memphis242/can_node_board/hardware/test_circuits/can_test/can_test_breadboard_setup.jpg

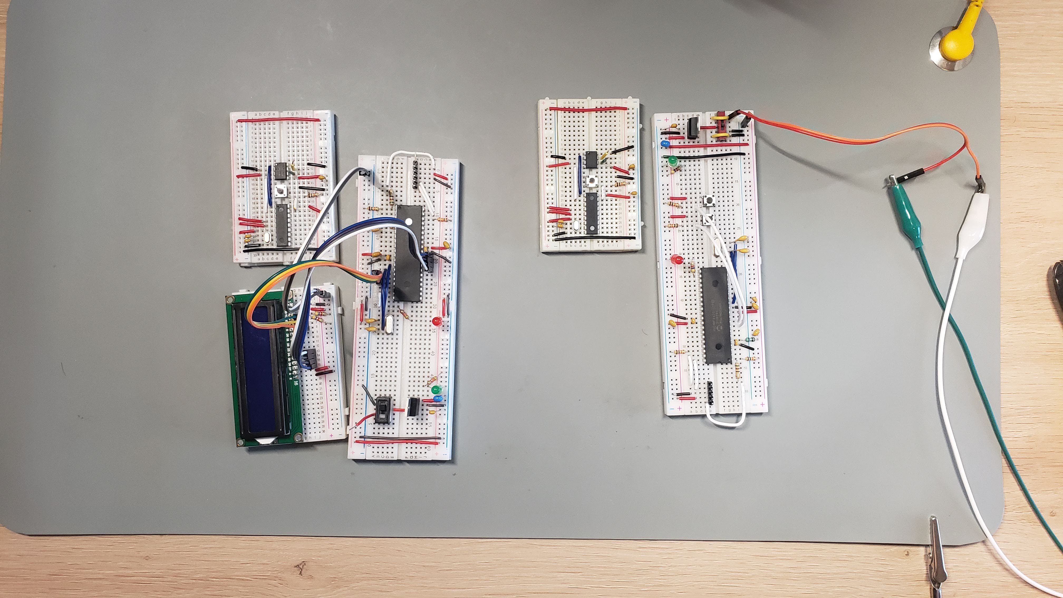
hardware/test_circuits/can_test/can_test_breadboard_setup.jpg
