memphis242/can_node_board/hardware/test_circuits/pic18f4620_can_test_sch.pdf

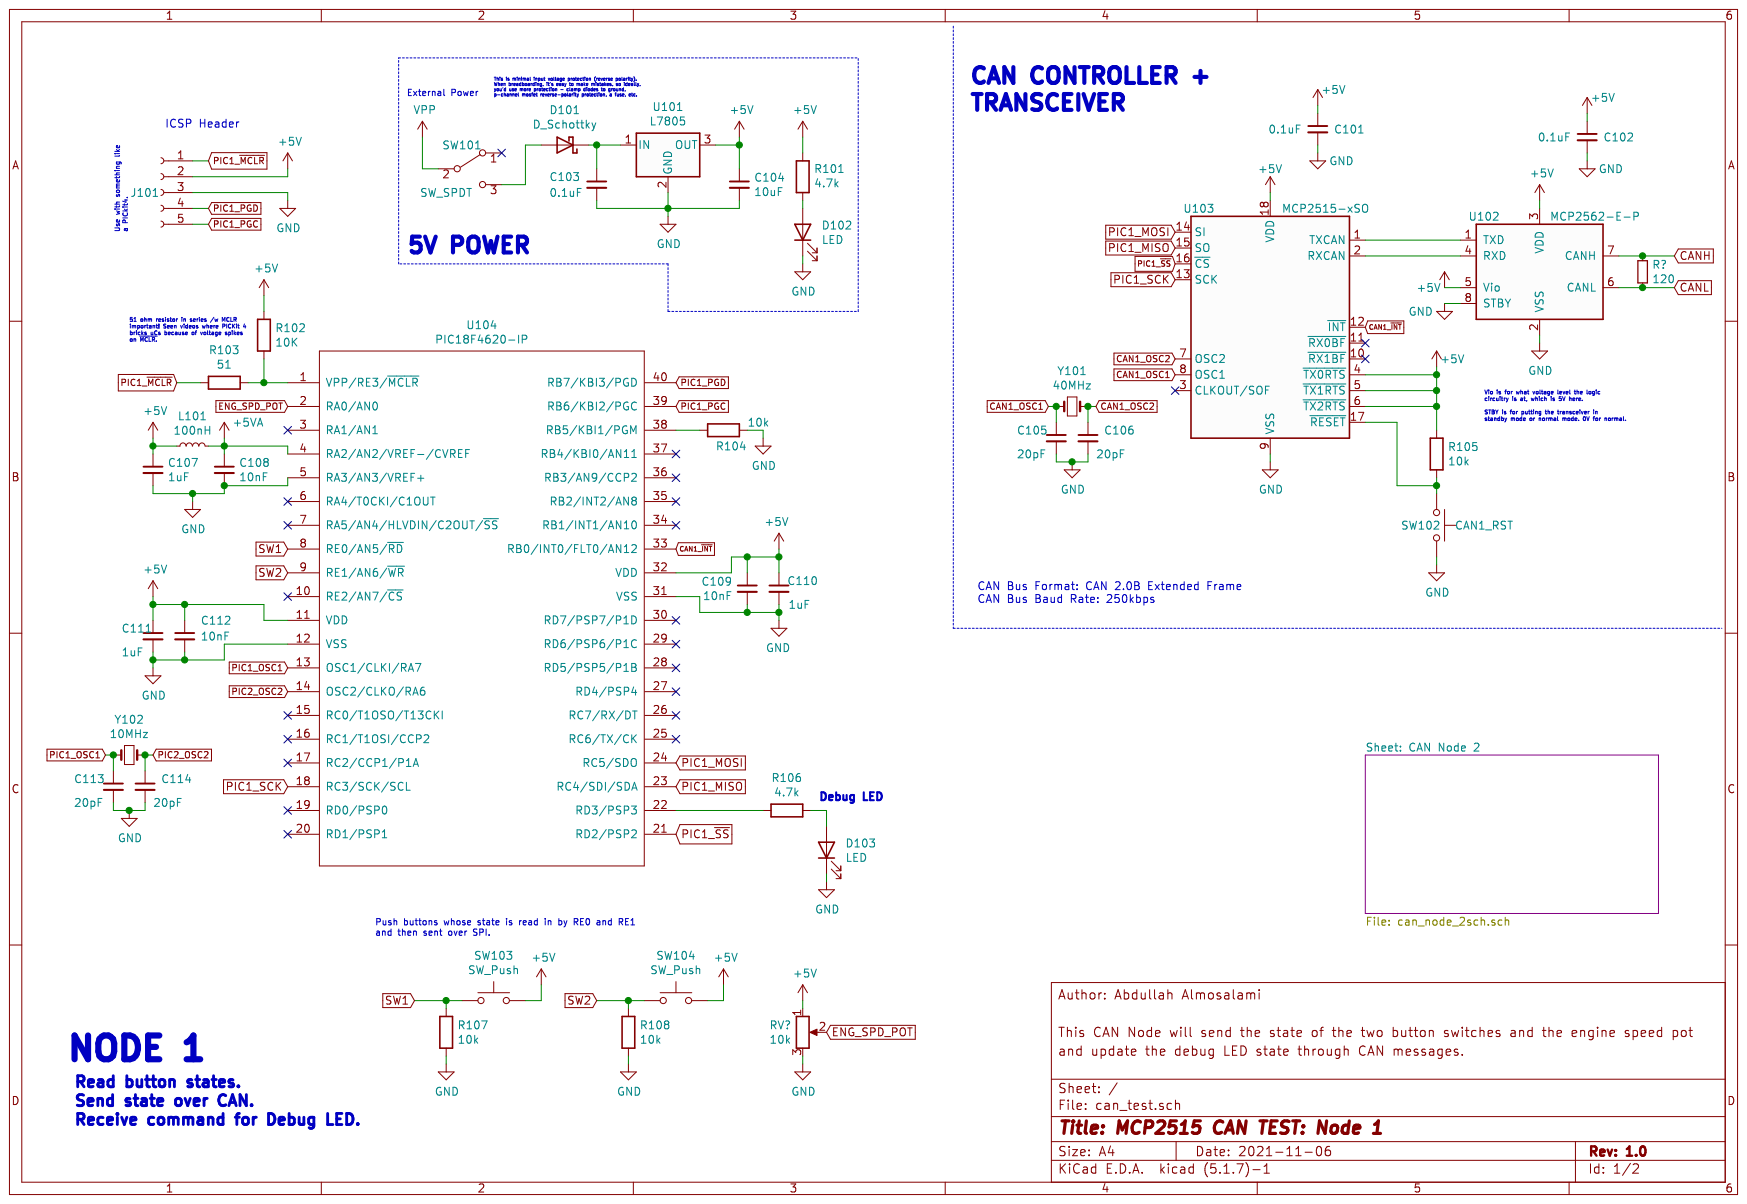
[picture p2: page 1]

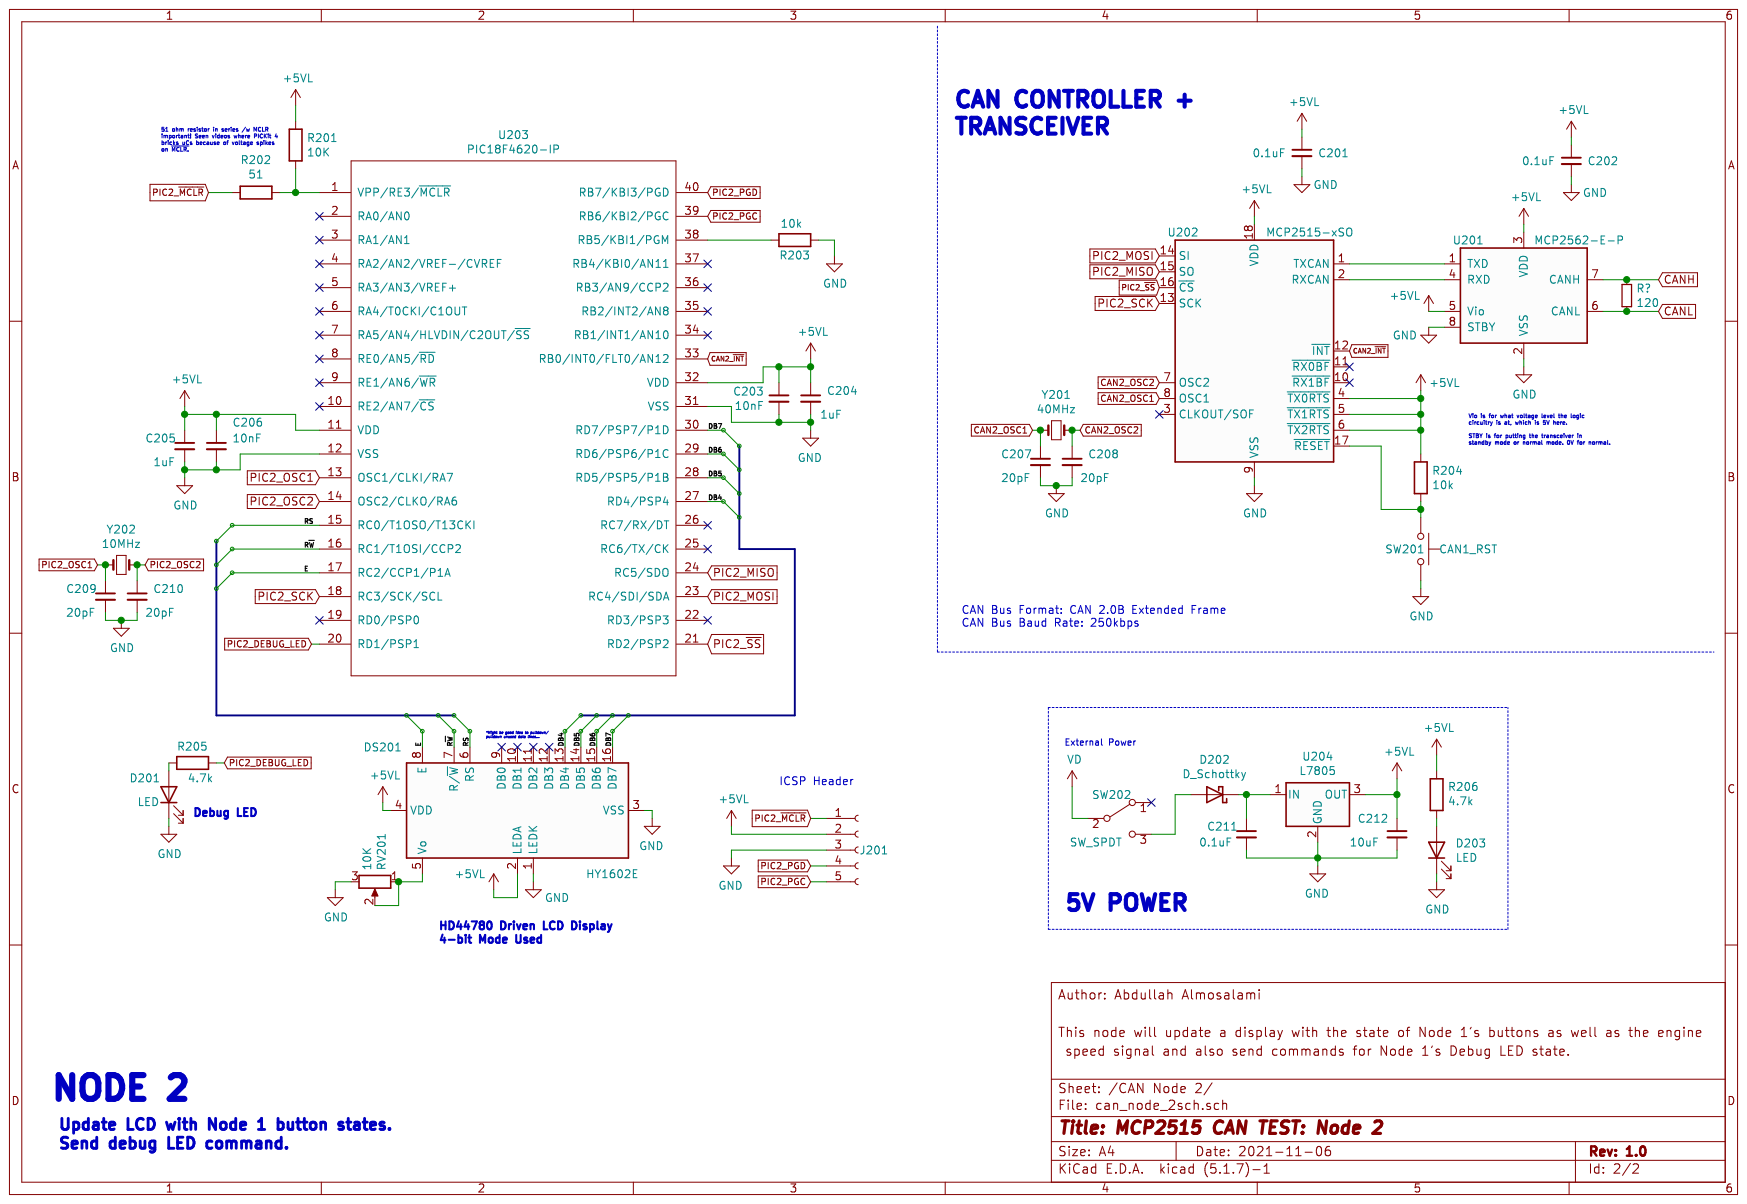
[picture p3: page 2]
