memphis242/can_node_board/hardware/test_circuits/pic18f4620_spi_test_sch.pdf

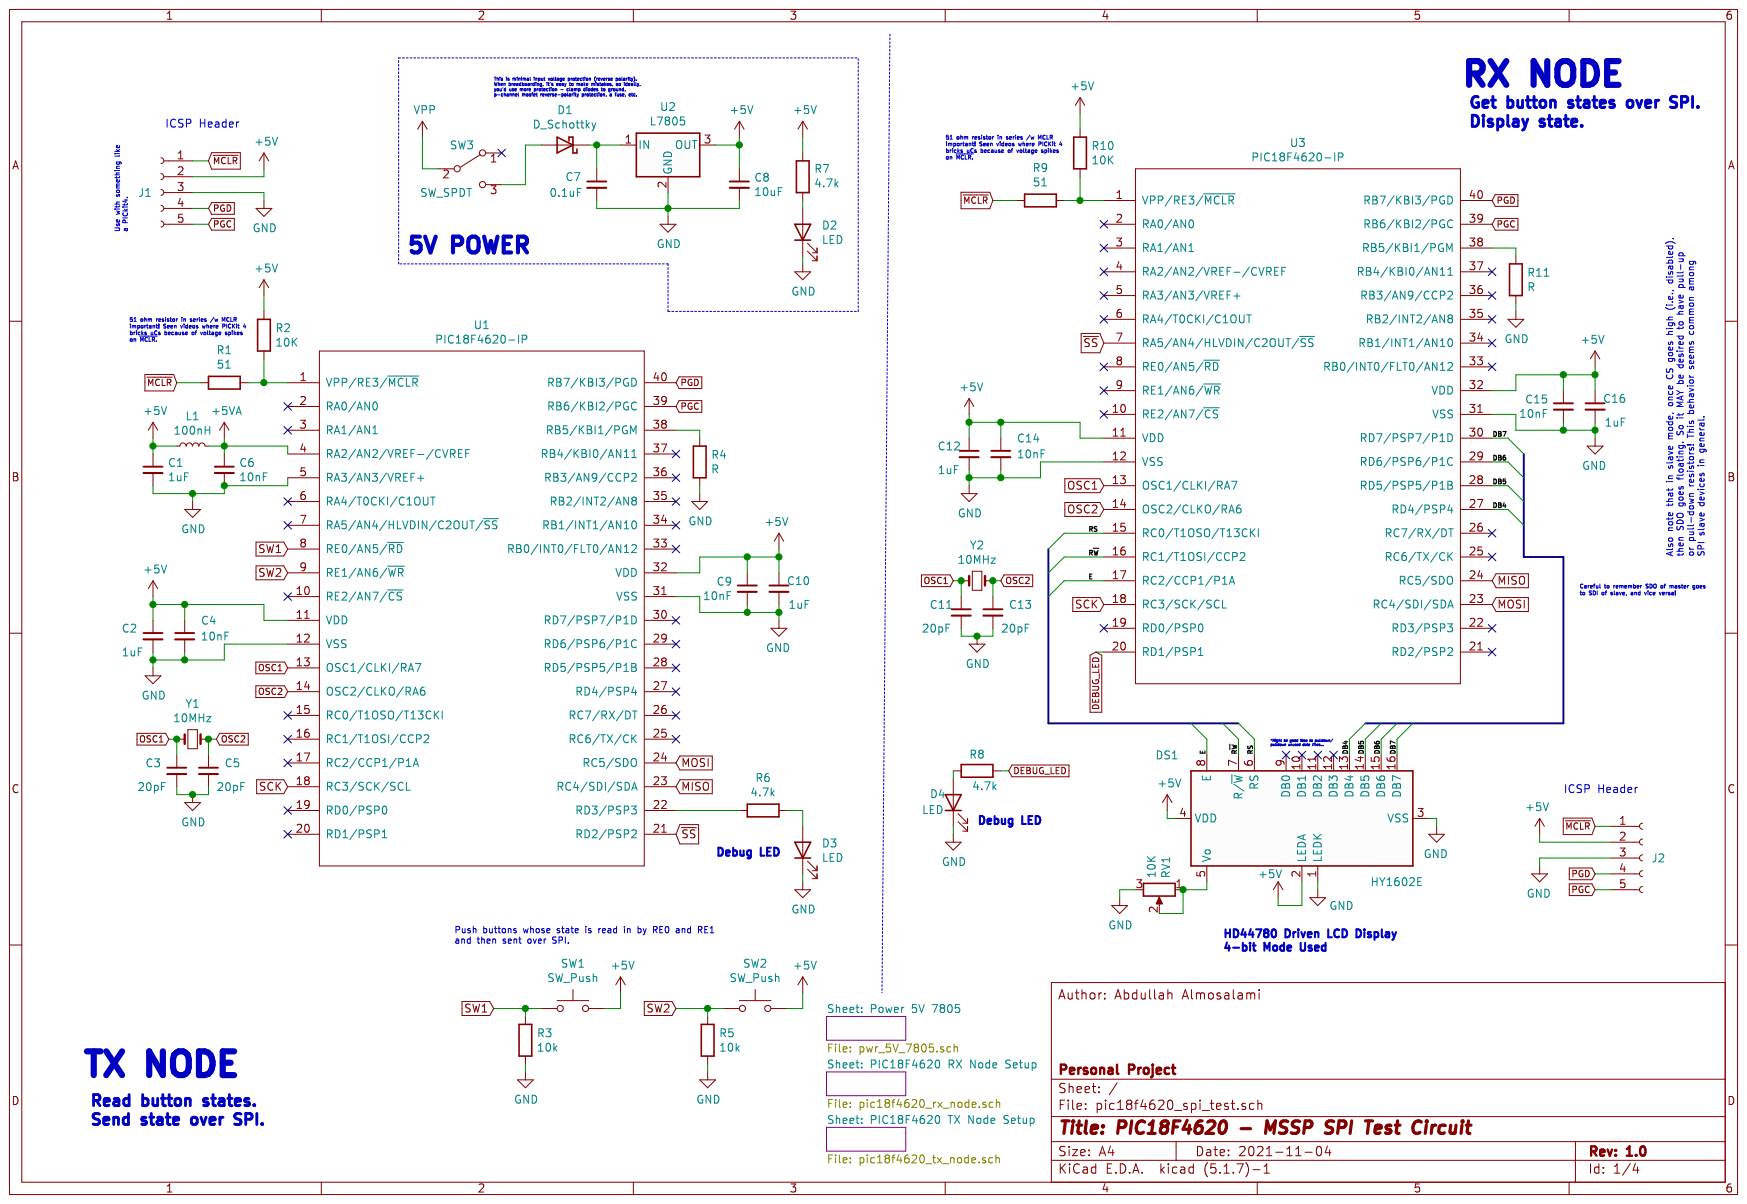
[picture p4: page 1]

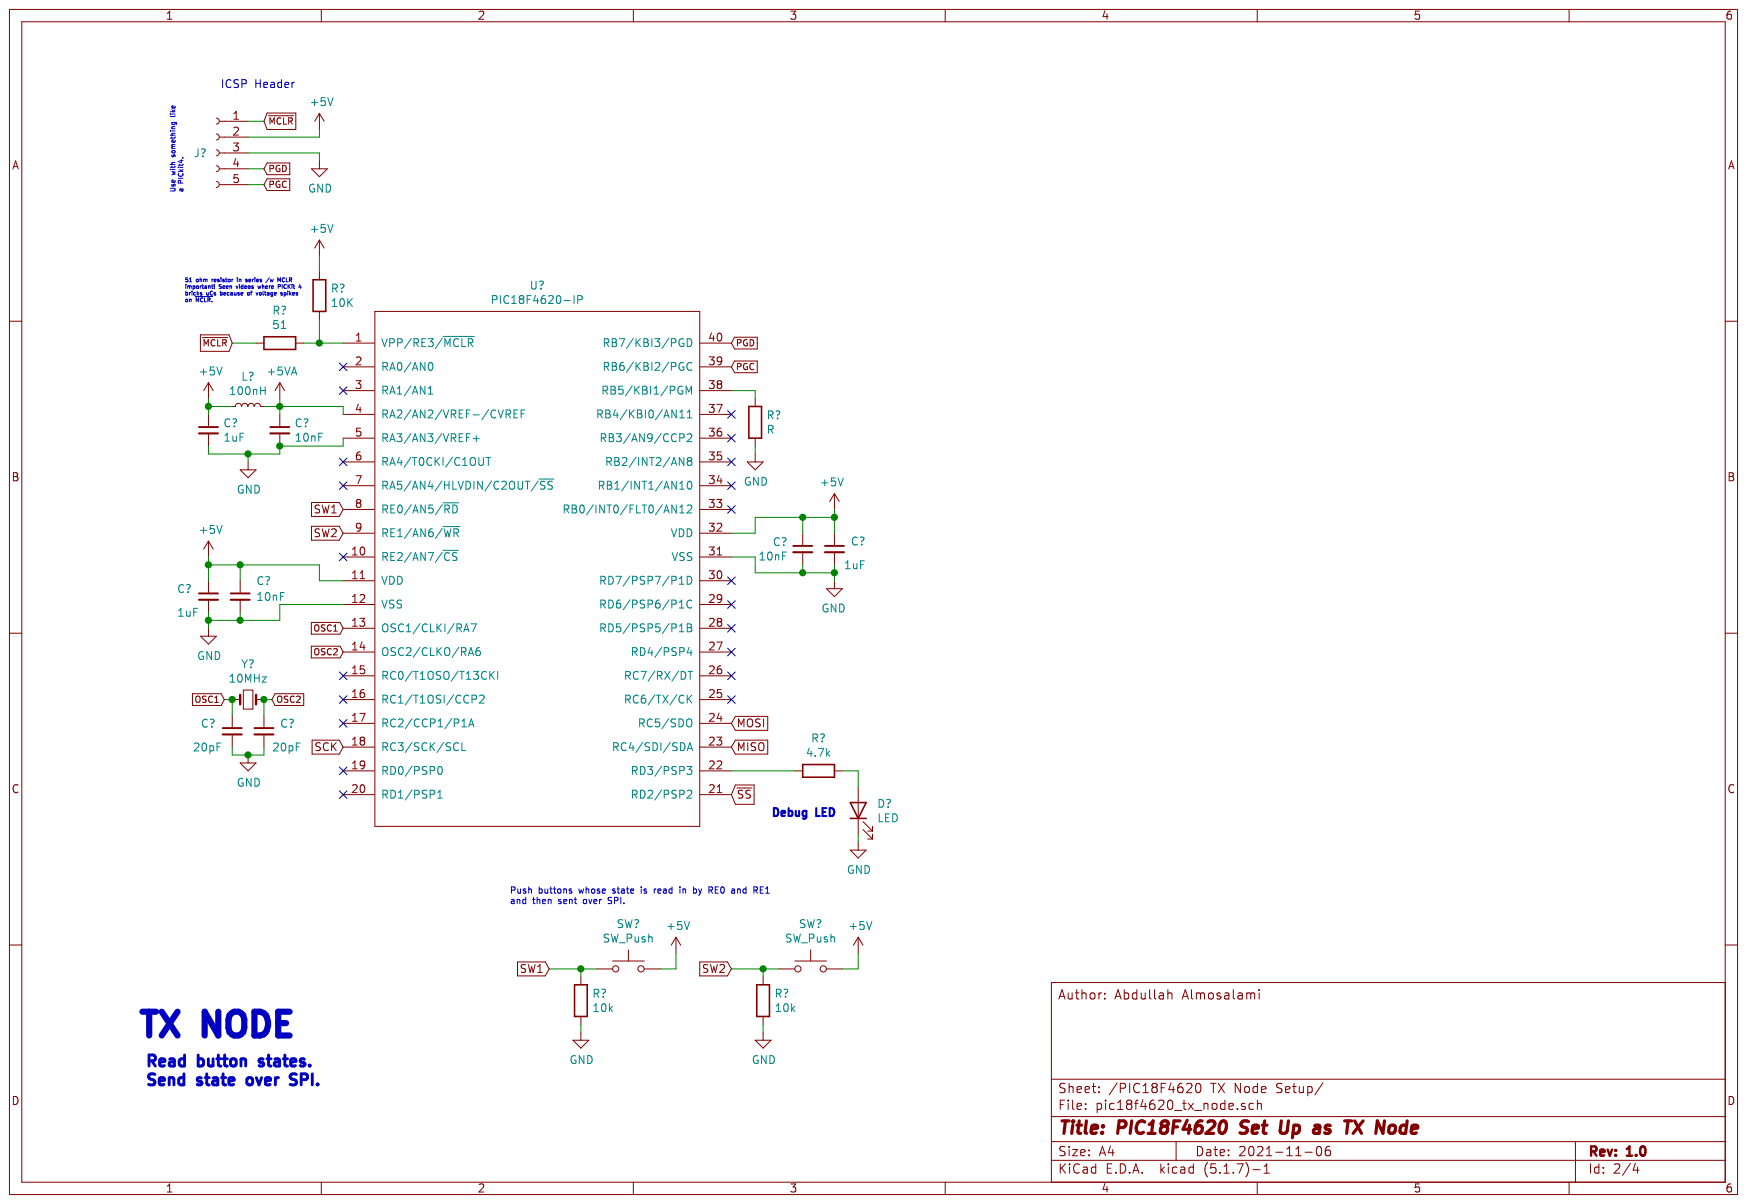
[picture p5: page 2]

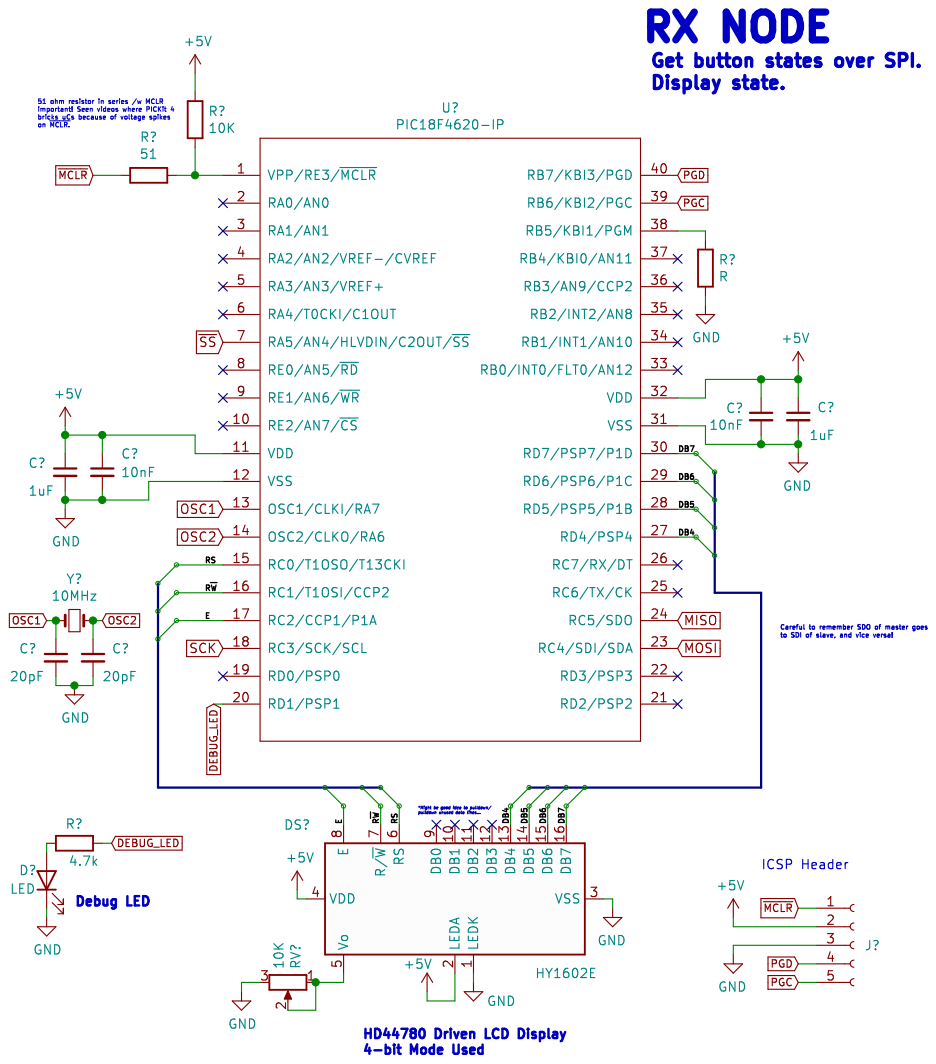
[picture p6: page 3]

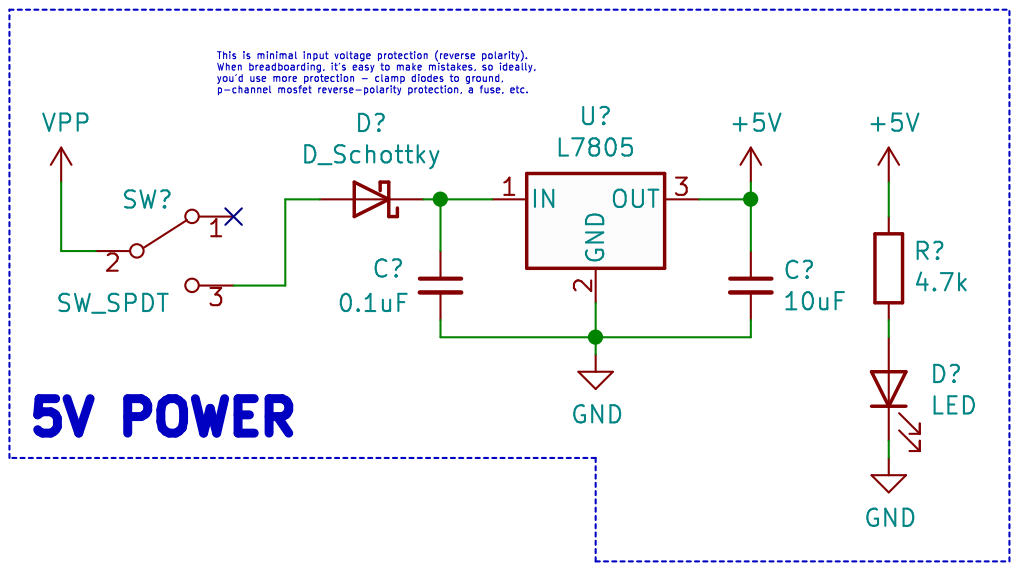
[picture p7: page 4]
