memphis242/can_node_board/can_node_board_SW.X/src/timer.c

/*
 * File:   timer.c
 * Author: Abdullah Almosalami
 *
 * Created on October 28, 2021, 10:12 PM
 */


#include <xc.h>
#include "timer.h"
#include "ccp.h"


// Global or static variables relevant to the timer modules


// Functions

// Timer1

/* Function: Timer1_Init_Default
 * ---------------------------------
 * Initialize Timer1 in the default manner, which for this project will be for
 * T1CON to be configured for 16-bit R/W, prescaler of 8, tmr1 osc off,
 * internal clock, tmr1 off
 * 
 * Parameters: none
 * 
 * Returns: none
 */
void Timer1_Init_Default(void){
    TMR1_DEFAULT;
    TMR1_PRESCAL_8;
//    TMR1_ENABLE_INTERRUPT;
//    ENABLE_PERIPHERAL_INTERRUPTS;
}

void Timer3_Init_Default(void) {
    TMR3_DEFAULT;
    TMR3_PRESCALE_8;
//    TMR3_ENABLE_INTERRUPT;
//    ENABLE_PERIPHERAL_INTERRUPTS;
}

/* Function: Timer1_Enable
 * ---------------------------------
 * Turns Timer1 on.
 * 
 * Parameters: none
 * 
 * Returns: none
 */
void Timer1_Enable(void){
    TMR1_ON;
}

/* Function: Timer1_Disable
 * ---------------------------------
 * Turns Timer1 off.
 * 
 * Parameters: none
 * 
 * Returns: none
 */
void Timer1_Disable(void){
    TMR1_OFF;
}

/* Function: Timer3_Enable
 * ---------------------------------
 * Turns Timer3 on.
 * 
 * Parameters: none
 * 
 * Returns: none
 */
void Timer3_Enable(void){
    TMR3_ON;
}

/* Function: Timer3_Disable
 * ---------------------------------
 * Turns Timer3 off.
 * 
 * Parameters: none
 * 
 * Returns: none
 */
void Timer3_Disable(void){
    TMR3_OFF;
}


//    // Timer1 Overflow Interrupt
//    if(TMR1_IF && TMR1_ENABLE_BIT) {
//        
//        spi_ready_to_tx = 0x01;
//        
//        TMR1_CLEAR_IF;
//    }
