memphis242/can_node_board/(commit log)

2021-11-03 Wrote up SPI test TX node code. Need to still do RX node.
2021-11-03 Wrote up SPI test code now for both TX and RX Test nodes! Now to try it out...
2021-11-04 Fixed up test code along with peripheral code for TX node. SPI, Timer, and CCP all work great! I also fixed some of the LCD code for the RX node. Next up, hopefully making the RX node work and then w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
    [ccp.c, ccp.h, lcd_driver.c, lcd_driver.h, main.c, mssp_spi_driver.c, timer.c, timer.h]
2021-11-04 Ok, I think I'm happy with most of the test results. The acknowledge behavior is still not working as I believe it should but hopefully this isn't too important for this project. I also moved the tes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
    [main.c, spi_test.c]
2021-11-04 Added hardware folder to hold schematic and pcb files.
    [can_node_board_hw.kicad_pcb, can_node_board_hw.sch, can_node_board_pwr.sch, can_node_board_user_interface.sch, can_test.kicad_pcb, can_test.sch, j1939_test.kicad_pcb, j1939_test.sch]
2021-11-05 Completed the schematic for the PIC18F4620 SPI Test. I will note that the KiCAD DRC on the schematic still gives --Pin connected to other pins, but not driven by any pin-- warnings, and I have not be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
    [can_node_board_pwr.sch]
2021-11-05 Added a pdf export of my pic18f4620 spi test schematic.
2021-11-06 Added more documentation. Also fixed up some of the SPI and LCD code.
    [ccp.c, ccp.h, lcd_driver.c, lcd_driver.h, mssp_spi_driver.c, spi_test.c, spi_test.h, timer.c]
2021-11-06 Finished CAN Node 1 schematic page.
    [can_node_2sch.sch]
2021-11-06 Finished CAN Test schematic now. Also added schematics for the individual elements used so that it would make it easier to reuse for later schematics!
    [can_test.sch, pic18f4620_rx_node.sch, pic18f4620_spi_test.sch, pic18f4620_tx_node.sch, pwr_5V_7805.sch]
2021-11-07 Fixed up issues I had with ccp and timer that I didn't realize I had! :-|
    [ccp.c, ccp.h, mcp2515.c, mcp2515.h, spi_test.c, timer.c, timer.h]
2021-11-09 Completed draft the mcp2515.h and did minor edits to schematics.
    [pic18f4620_spi_test.sch]
2021-11-11 Fixed up some of the peripheral drivers.
    [ccp.c, ccp.h, lcd_driver.c, lcd_driver.h, mcp2515.h, timer.c, timer.h]
2021-11-11 Added a little to mcp2515.c and realized I would like to add file for external interrupts. So added external_interrupts.c and .h.
2021-11-12 Completed this first version of the external interrupt files.
2021-11-12 Added a little more to the mcp2515.c file and edited other files as I notice things like the spi files...
2021-11-15 Realized I probably want to actually use the ~INT pin on the MCP2515 for recognizing when a transmission has successfull occured... And if I'm using that, might as well also use it for RX interrupts 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
    [can_node_2sch.sch, can_test.sch]
2021-11-15 Complete the can_send routine --> will need to set up ISR as well still! Will include this as a comment at the end of the mcp2515.c file.
    [can_node_2sch.sch, can_test.sch]
2021-11-15 Ok. I think I've completed the draft MCP2515 driver files. Woo! That took a HOT SEC. Although I'm sure I'll find lots of bugs once I begin testing :).
    [mcp2515.c, mcp2515.h]
2021-11-16 Added in a potentiometer for Node 1 to act as an Engine Speed Signal' to drive the point of this project a little more...
    [can_node_2sch.sch, can_test.sch]
2021-11-16 Wrote up ADC peripheral driver files. Now need to continue writing test code.
2021-11-16 Freaken forgot 120ohm termination resistors on the CANH and CANL lines! Doi!
    [can_node_2sch.sch, can_test.sch]
